hhtronik/qok-i-can-solder-challenge/designspark/Readme.md

ECAD Files / How to open?
=========================

These files are RS Online DesignSpark PCB schematic (`.sch`) and pcb design files (`.pcb`).
You can get a free copy of DesignSpark PCB at [RS Online](https://www.rs-online.com/designspark/pcb-software)
