hhtronik/qok-i-can-solder-challenge/schematic.pdf

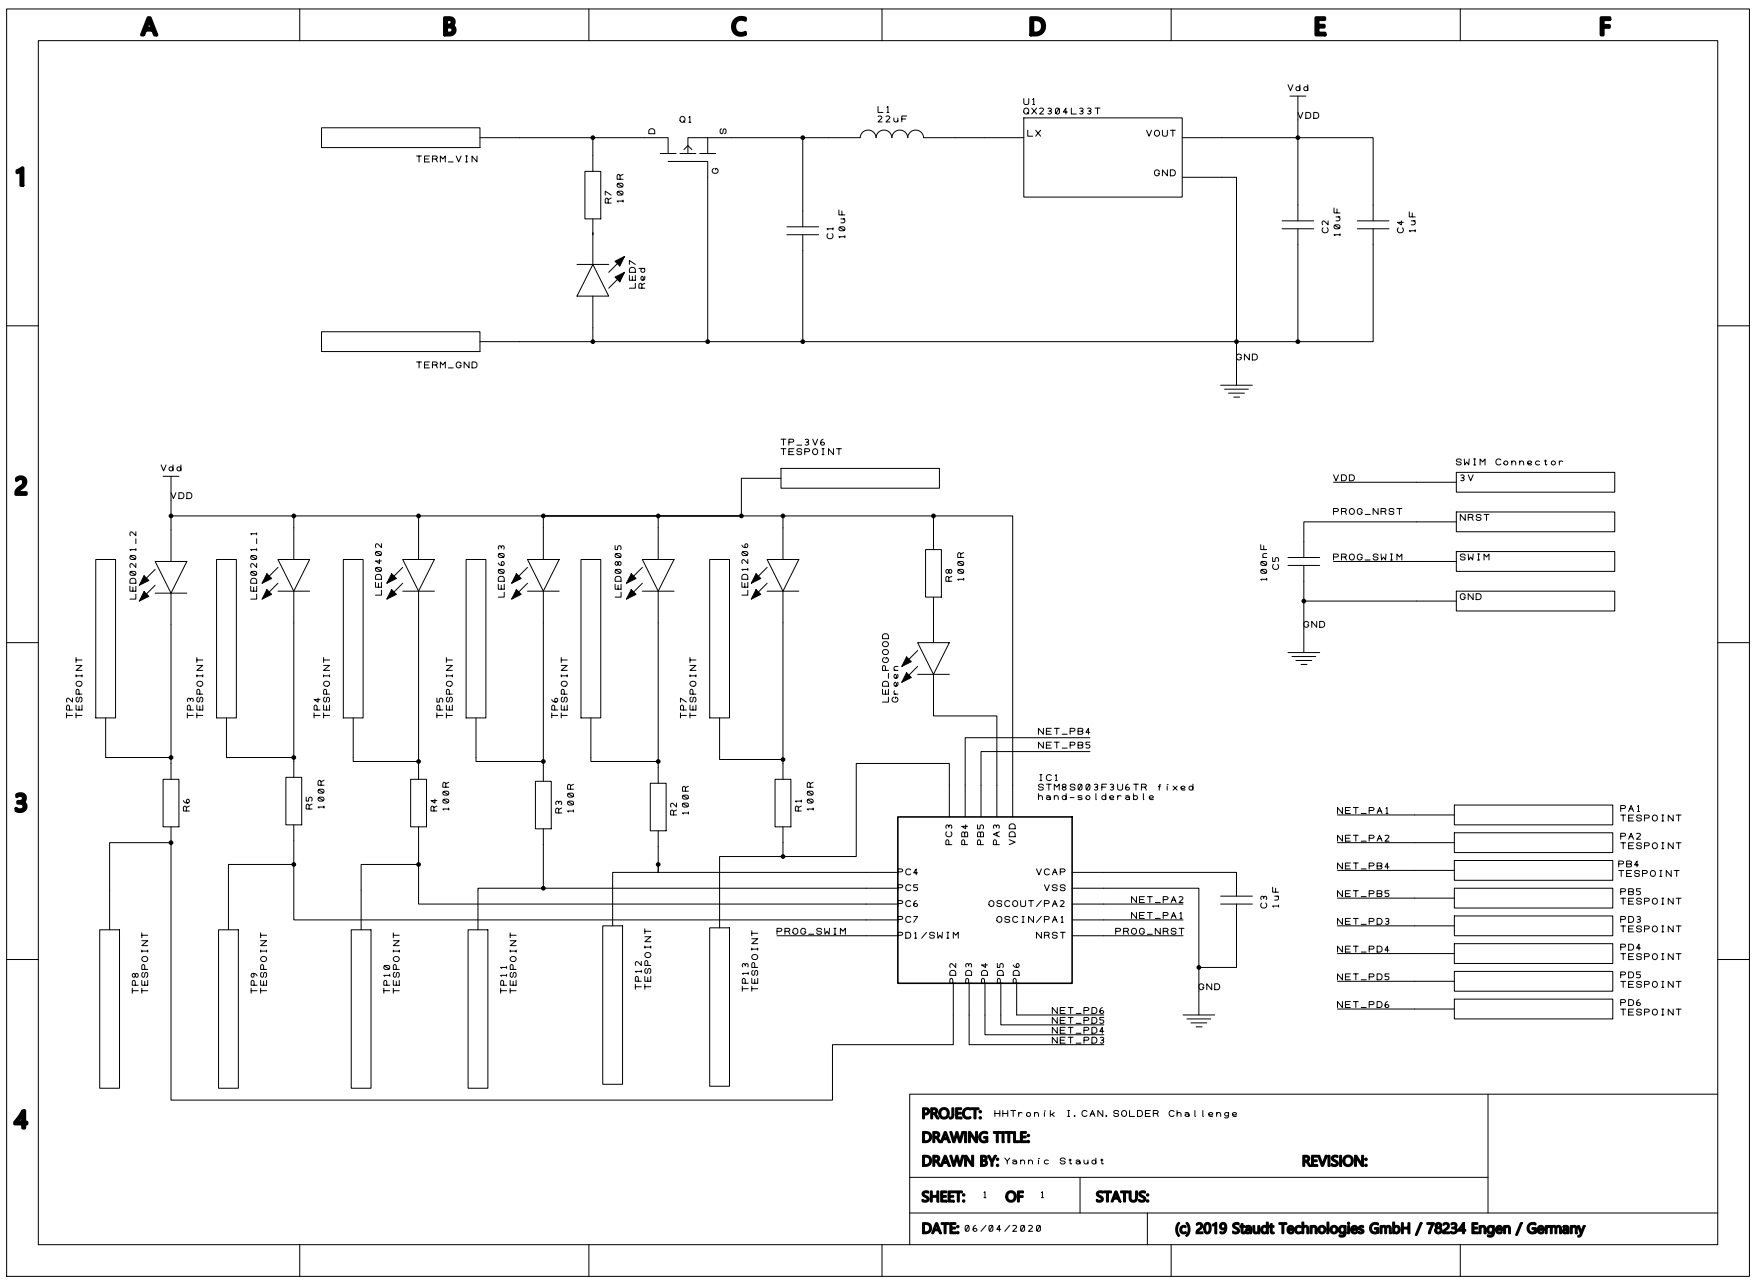
[picture p3: page 1]
