hhtronik/qok-i-can-solder-challenge/(list of files, drawings)

Other design files:
designspark/hhtqok-ics-challenge.pcb
