hhtronik/qok-i-can-solder-challenge/(commit log)

2020-04-01 Fixed the BOM / parts list
    [hhtqok-ics-challenge.sch]
2020-04-01 First firmware stub (no hardware available to test. Probably doesn't work as expected)
    [macros.h, main.c, stm8s003.h, systick.c, systick.h]
2020-04-06 Improved STM8 footprint for hand solderability and added breakout pads for all ununsed uC pins
    [hhtqok-ics-challenge.pcb, hhtqok-ics-challenge.sch]
2020-06-19 Added some help with soldering
2020-06-19 Fixed BOM (missing current limiting resistors)
